HaoguangYang/rallycar/firmware/README.md

The Arduino hosts the IMU sensor on the I2C bus, and 8-bit PWM signals that drives the ESC (driving motor) and the servo (steering motor).
