HaoguangYang/rallycar/hardware/hokuyo_d435i_shield.SLDPRT

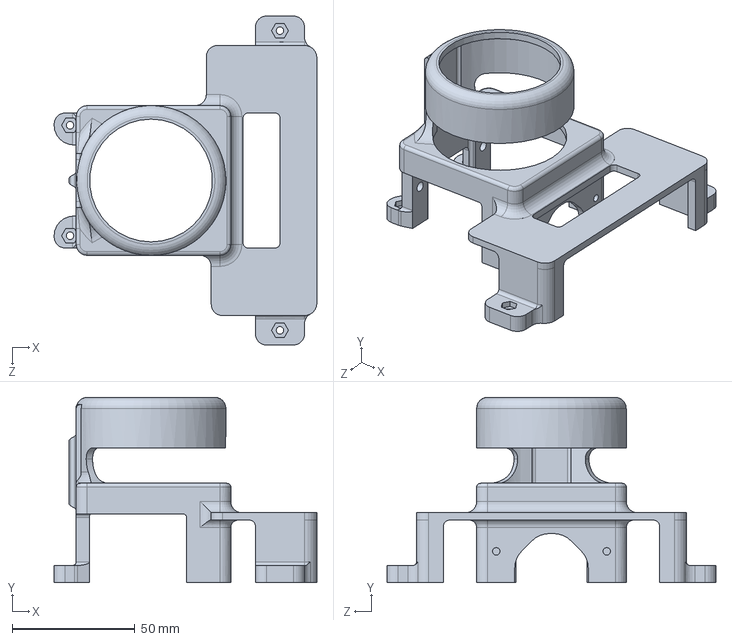
[picture p8: CAD file, 2024-03-07]
hardware/hokuyo_d435i_shield.SLDPRT
107.1 x 75.5 x 134.0 mm
