HaoguangYang/rallycar/(list of files, cad)

Other CAD files:
hardware/hokuyo_d435i_shield.STL
