HaoguangYang/rallycar/hardware/wiring_scehmatics.pdf

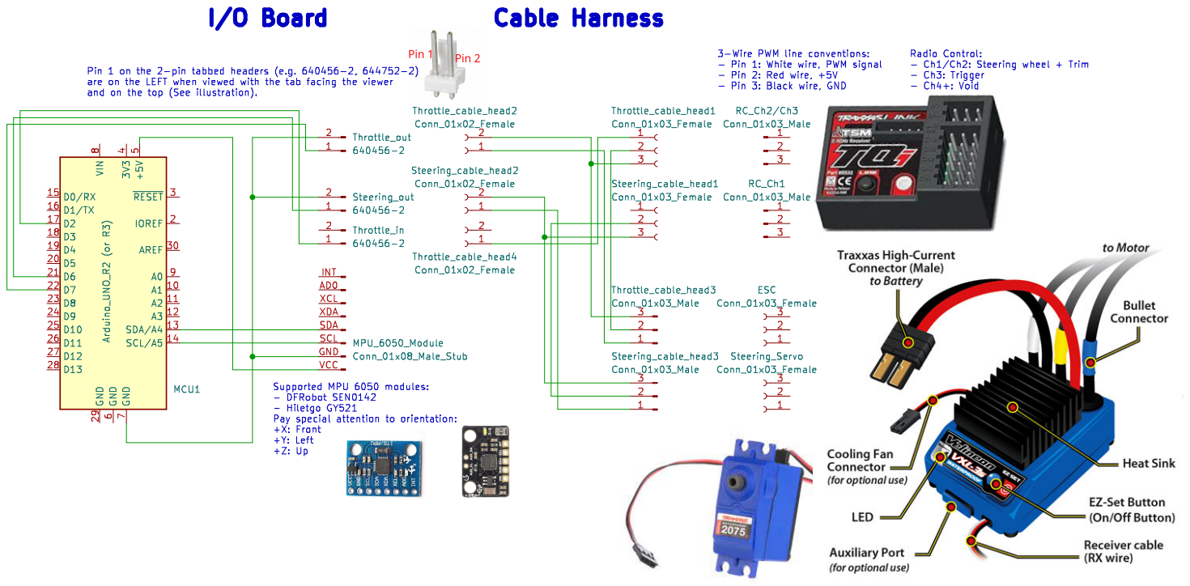
[picture p9: page 1]
