HaoguangYang/rallycar/hardware/wiring_schematics.kicad_sch

## KiCad design hardware/wiring_schematics.kicad_sch (2024-03-20)

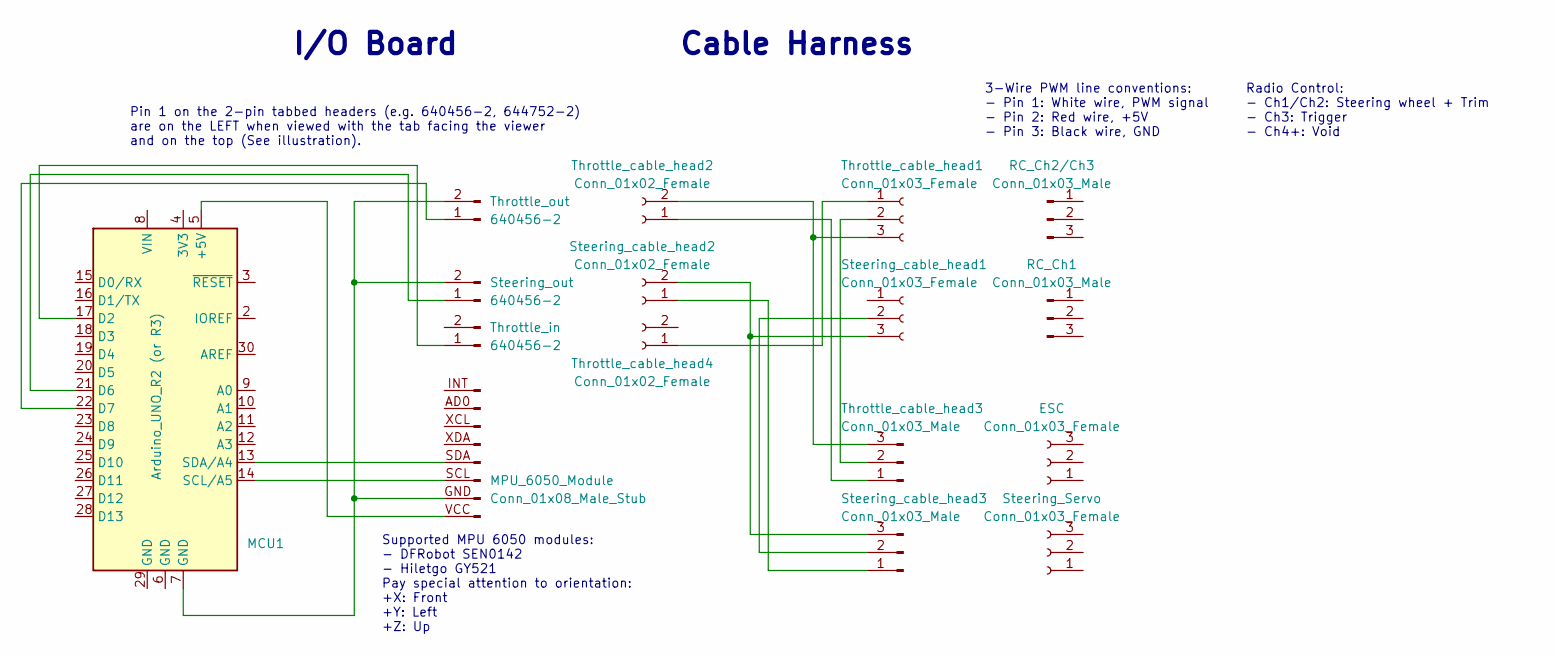
[picture p10: schematic wiring_schematics.kicad_sch]

Parts:
ESC: Conn_01x03_Female
MCU1: Arduino_UNO_R2 (or R3); Arduino_UNO_R2
MPU_6050_Module: Conn_01x08_Male_Stub
RC_Ch1, RC_Ch2/Ch3: Conn_01x03_Male
Steering_Servo: Conn_01x03_Female
Steering_cable_head1: Conn_01x03_Female
Steering_cable_head2: Conn_01x02_Female
Steering_cable_head3: Conn_01x03_Male
Steering_out: 640456-2
Throttle_cable_head1: Conn_01x03_Female
Throttle_cable_head2, Throttle_cable_head4: Conn_01x02_Female
Throttle_cable_head3: Conn_01x03_Male
Throttle_in: 640456-2
Throttle_out: 640456-2

Connections:
unnamed: MCU1.5 (+5V), MPU_6050_Module.VCC (Pin_1)
unnamed: MCU1.7 (GND), MPU_6050_Module.GND (Pin_2), Steering_out.2, Throttle_out.2
unnamed: MCU1.13 (SDA/A4), MPU_6050_Module.SDA (Pin_4)
unnamed: MCU1.14 (SCL/A5), MPU_6050_Module.SCL (Pin_3)
unnamed: MCU1.17 (D2), Throttle_in.1
unnamed: MCU1.21 (D6), Steering_out.1
unnamed: MCU1.22 (D7), Throttle_out.1
unnamed: Steering_cable_head1.2, Steering_cable_head3.2
unnamed: Steering_cable_head1.3, Steering_cable_head2.2, Steering_cable_head3.3
unnamed: Steering_cable_head2.1, Steering_cable_head3.1
unnamed: Throttle_cable_head1.1, Throttle_cable_head4.1
unnamed: Throttle_cable_head1.2, Throttle_cable_head3.2
unnamed: Throttle_cable_head1.3, Throttle_cable_head2.2, Throttle_cable_head3.3
unnamed: Throttle_cable_head2.1, Throttle_cable_head3.1

Notes on the sheet:
Supported MPU 6050 modules: - DFRobot SEN0142 - Hiletgo GY521 Pay special attention to orientation: +X: Front +Y: Left +Z: Up
Radio Control: - Ch1/Ch2: Steering wheel + Trim - Ch3: Trigger - Ch4+: Void
I/O Board
Pin 1 on the 2-pin tabbed headers (e.g. 640456-2, 644752-2) are on the LEFT when viewed with the tab facing the viewer and on the top (See illustration).
Cable Harness
3-Wire PWM line conventions: - Pin 1: White wire, PWM signal - Pin 2: Red wire, +5V - Pin 3: Black wire, GND
