HaoguangYang/rallycar/(commit log)

2024-03-07 added base software package
    [hokuyo_d435i_shield.SLDPRT, hokuyo_d435i_shield.STL, rallycar.urdf]
2024-03-07 safety bugfix - signal cropping performed before mapping
    [rallycar_arduino_v2024.2.ino]
2024-03-16 added witing diagram for the IO board
    [wiring_schematics.kicad_sch]
2024-03-18 standardize lidar IP address. Added rviz screenshot when building path
2024-03-19 updated driver firmware to use non-hardcoded IMU calibration values
2024-03-20 added battery management docs, updated deadman switch assignment
    [wiring_schematics.kicad_sch]
